Spadeyache/FATEN-RCJ26/k230-inference/data/captures/README.txt

/data/captures/ - BOOT-button camera captures are saved here.
