Spadeyache/FATEN-RCJ26/Docs/architecture.html

## How the Teensy, XIAO & K230D work as one system

A top-to-bottom map of the rescue robot's brain. The Teensy 4.1 is the conductor: it pulls in pre-chewed data from two smart co-processors (the XIAO ESP32-S3 camera and the K230D AI processor) plus its own onboard sensors, fuses and filters everything, decides which behaviour to run, and finally drives four wheels. Read top to bottom — each section zooms one level deeper.

Co-processor / sensor (input) Teensy processing Decision / state Actuator (output)

## 1 · The whole robot at a glance

Everything the Teensy reads is already simplified by the time it arrives. The XIAO does the heavy camera vision and hands over a few bytes; the K230D runs a YOLO model and hands over bounding boxes. The Teensy never touches raw pixels — it works with small, fast messages.

flowchart LR subgraph SRC["INPUTS — smart co-processors & sensors"] direction TB XIAO["📷 XIAO ESP32-S3
runs camera vision
(line, green, red, silver, gap)"] K230["🧠 K230D AI processor
YOLO model
(victim bounding boxes)"] IMU["🧭 IMU MPU6050
pitch / roll / yaw"] TOF["📏 ToF VL53L7CX
distance / walls"] TCH["👆 Touch + conductive
bump / wall contact"] end subgraph TEENSY["TEENSY 4.1 — the conductor"] direction TB RX["Raw byte transport
sensors/ layer"] PROC["Decode · filter · fuse
processing/ layer"] STATE["State machine
pick a behaviour"] ACT["Actions
PID, turn, forward, arm"] RX --> PROC --> STATE --> ACT end subgraph OUT["OUTPUTS"] direction TB MOT["⚙️ 4× STS wheels
FL FR BL BR"] ARM["🦾 KRS arm / gripper"] end XIAO -- "UART3 @ 4 Mbps
register protocol" --> RX K230 -- "UART8 @ 115k
frame protocol" --> RX IMU -- "I²C" --> RX TOF -- "I²C" --> RX TCH -- "GPIO" --> RX ACT -- "STS bus @ 1 Mbps" --> MOT ACT -- "KRS bus" --> ARM XIAO -. "mode cmd (LINE/EVAC/GAP)" .- PROC classDef src fill:#102a2c,stroke:#39c5cf,color:#e6edf3; classDef proc fill:#241a33,stroke:#bc8cff,color:#e6edf3; classDef dec fill:#2b2410,stroke:#d29922,color:#e6edf3; classDef out fill:#10271a,stroke:#3fb950,color:#e6edf3; class XIAO,K230,IMU,TOF,TCH src; class RX,PROC proc; class STATE dec; class ACT,MOT,ARM out;

Key idea: the Teensy is not doing image processing. The XIAO and K230D are offloaded brains that pre-digest the camera into tiny messages. This keeps the Teensy's control loop fast and deterministic.

## 2 · The 5-layer architecture

All firmware lives under src/<layer>/. The rule is strict: calls only flow downward. A layer never calls a layer above it. This is what keeps the "spaghetti" out — each box below only knows about the box beneath it.

flowchart TB SM["state_machine/
orchestrates behaviour
LINE_Follow · LINE_Gap · LINE_Obstacle · EVAC_*"] AC["actions/
blocking high-level motions
Drive (PID) · Turn · Forward · Arm"] PR["processing/
decode · filter · fuse
XiaoDecode · K230Decode · CommandFilter · Pose/EKF · Mapping"] SE["sensors/
raw I/O wrappers
XIAO_link · K230_link · IMU · ToF · Touch"] DR["drivers/
per-chip register wrappers
yacheSTS · yacheMPU6050 · yacheVL53L7CX · yacheEncodedSerial"] HW["🔌 hardware
UART · I²C · GPIO"] SM --> AC --> PR --> SE --> DR --> HW classDef dec fill:#2b2410,stroke:#d29922,color:#e6edf3; classDef out fill:#10271a,stroke:#3fb950,color:#e6edf3; classDef proc fill:#241a33,stroke:#bc8cff,color:#e6edf3; classDef src fill:#102a2c,stroke:#39c5cf,color:#e6edf3; classDef hw fill:#161b22,stroke:#30363d,color:#9da7b3; class SM dec; class AC out; class PR proc; class SE,DR src; class HW hw;

actions/
Blocking motions you call and wait on: Turn::turn(180,60), Forward::forward(60,35), Drive::runLinePID().

processing/
Turns raw bytes into meaning: a confirmed command code, a line error, a victim direction, a pose.

sensors/
Just moves bytes in/out. XIAO_link::get(reg) / send(reg,val). No interpretation.

drivers/
Per-chip register code (the "yache" wrappers). Speaks the actual chip language.

Adding new code? A new chip → drivers/. Reading raw bytes → sensors/. Decoding/fusing them → processing/. A motion primitive → actions/. A new behaviour → state_machine/.

## 3 · The main loop — one pass, every cycle

STS-imuMerge.ino → loop() is deliberately tiny. It runs the same 4-step pipeline forever: pump I/O → process → handle debug → run the active state.

flowchart LR A["1 · Pump sensor I/O
XIAO_link::tick()
K230_link::tick()
IMU / Touch tick()"] B["2 · Processing
XiaoDecode::tick()
K230Decode::tick()
(decode + filter + fuse)"] C["3 · Debug serial
'm' = map dump
'p' = pose print"] D["4 · Run active state
StateMachine::tick()
→ dispatches to current state"] A --> B --> C --> D D -. "loop forever" .-> A classDef proc fill:#241a33,stroke:#bc8cff,color:#e6edf3; classDef dec fill:#2b2410,stroke:#d29922,color:#e6edf3; class A,B,C proc; class D dec;

loop() {
Sensors::XIAO_link::tick(); // 1 — drain RX into register cache
Processing::XiaoDecode::tick(); // 2 — read cache, vote, expose lineError/command
while (Serial.available()) Mapping::handleSerial(...); // 3
StateMachine::tick(); // 4 — act
}

Why two steps per sensor? Step 1 (sensors/) only moves bytes — fast, non-blocking. Step 2 (processing/) interprets them. Splitting them means the transport never blocks on decode logic, and decode always works on the freshest cache.

## 4 · The XIAO ESP32-S3 path primary vision input

The XIAO runs the camera and boils each frame down to a handful of registers. Communication is a tiny register protocol over UART3 at 4 Mbps using YacheEncodedSerial — a 3-byte packet [255, reg, value].

### The register protocol

Register | ID | Direction | Meaning
XIAO_REG_FEATURE | 0x01 | Xiao → Teensy | Detected feature byte (green, red, silver, intersection, gap…) — the noisy raw vote
XIAO_REG_COM | 0x02 | Xiao → Teensy | Line centre-of-mass, 0..254 (127 = centred) — the steering error
XIAO_REG_ANGLE | 0x04 | Xiao → Teensy | Gap line angle, 0..254 (127 = 0°) — only meaningful in GAP mode
XIAO_REG_MODE | 0x03 | Teensy → Xiao | Tells the XIAO which vision program to run (see below)

### Teensy steers the XIAO's "mode"

The Teensy can re-task the camera by writing XIAO_REG_MODE. This is the one upward message — the state machine swaps the camera's job to match the behaviour it's running.

0 · LINE
Follow the black line, watch for green/red/silver/intersection glyphs.

1 · EVAC
Evacuation-zone vision.

2 · NOGI
No-green-intersection disambiguation (which arm of the cross to take).

3 · GAP
Line-gap mode — reports a gap angle to re-acquire the line.

### What the decode layer does with it

flowchart LR RAW["Register cache
XIAO_link::get(reg)"] COM["lineError()
= COM register
updated EVERY loop"] ANG["gapAngle()
= ANGLE register"] FEAT["FEATURE byte"] FILT["CommandFilter
majority vote @ 50 Hz
(15-frame ring buffer)"] CMD["command()
confirmed code 1–8"] RAW --> COM RAW --> ANG RAW --> FEAT --> FILT --> CMD classDef proc fill:#241a33,stroke:#bc8cff,color:#e6edf3; classDef src fill:#102a2c,stroke:#39c5cf,color:#e6edf3; class RAW src; class COM,ANG,FEAT,FILT,CMD proc;

Two speeds on purpose. lineError (steering) is time-critical, so it's read raw every loop. The FEATURE byte is noisy, so it's only trusted after surviving a vote — see next section.

## 5 · CommandFilter — turning noisy glyphs into trusted commands

A single camera frame can lie (motion blur, glare). So the raw FEATURE byte is never acted on directly. Instead, every value drops into a 15-slot ring buffer, and a command is only "confirmed" once it collects enough votes. Different events need different thresholds — a U-turn must be very sure; a line-loss can react faster.

flowchart TB IN["raw FEATURE byte
(each 50 Hz tick)"] Q["15-frame ring buffer
oldest vote falls off"] TALLY["Tally votes per category
left · right · u-turn · red · silver · black · no-line"] CHK{"reached
threshold?"} CONF["confirmed command 1–8"] ZERO["0 — nothing confirmed yet"] IN --> Q --> TALLY --> CHK CHK -- yes --> CONF CHK -- no --> ZERO classDef proc fill:#241a33,stroke:#bc8cff,color:#e6edf3; classDef dec fill:#2b2410,stroke:#d29922,color:#e6edf3; class IN,Q,TALLY proc; class CHK dec; class CONF,ZERO proc;

### Confirmed command codes & what they trigger

Code | Meaning | Threshold | LINE_Follow reaction
1 | U-turn glyph (green both sides) | ≥2 u-turn glyphs, or strong dual-green | 180° spin in place
2 | Green left | 4 votes | forward 35 mm + turn −75°, then green-cooldown
3 | Green right | 4 votes | forward 35 mm + turn +75°, then green-cooldown
4 | Red (stop) tile | 5 votes | → STALLED_RED (idle until red clears)
5 | Silver (evac entrance) | 4 votes | → EVAC_ENTRY
6 | No-green intersection | 6 black votes, ≤2 green | NGI sub-sequence (stop, NOGI mode, resample, go straight)
7 | NGI back-up variant | 2 black, 0 green | NGI sub-sequence (90° branch — future work)
8 | Sustained line loss | 3 votes | → LINE_GAP
0 | nothing confirmed | — | just run the line PID

Clever bit: the U-turn glyph (code 1) also counts as one vote toward both left and right, so a normal single-side green approach can never accidentally cross the U-turn threshold. Precedence: red → silver → u-turn → green → intersection → no-line.

## 6 · The K230D AI path victim detection

The K230D is a dedicated AI processor running a YOLO model. It streams bounding boxes over UART8 at 115 kbps. The Teensy sends it a 1-byte command every 100 ms — 0x00 idle or 0x01 detect — and parses the frames that come back.

### Wire format (binary frame)

[0xAA][0x55][COUNT] ( [CLS][SCORE][X1hi][X1lo][Y1hi][Y1lo][X2hi][X2lo][Y2hi][Y2lo] ) × COUNT [CHKSUM]

Each box = 10 bytes (class, score, and a hi/lo bounding rectangle). CHKSUM = XOR of every byte from the 0xAA header through the last box byte. Frame parsing lives in processing/K230Decode; the sensors/K230_link layer just buffers bytes and never understands framing.

flowchart LR K["K230D YOLO"] LINK["K230_link
buffer RX bytes
send 0x00/0x01 @ 10 Hz"] DEC["K230Decode
find header · check COUNT
verify XOR checksum"] BOX["decoded boxes
cls · score · x1y1x2y2"] VIC["checkVictim()
pick best silver/black"] GOAL["goalPOS
direction = (cx−320)/320
valid · cls · score"] K -- "UART8" --> LINK --> DEC --> BOX --> VIC --> GOAL GOAL -.-> EVAC["used by EVAC_Search
to drive toward a victim"] classDef src fill:#102a2c,stroke:#39c5cf,color:#e6edf3; classDef proc fill:#241a33,stroke:#bc8cff,color:#e6edf3; classDef dec fill:#2b2410,stroke:#d29922,color:#e6edf3; class K,LINK src; class DEC,BOX,VIC,GOAL proc; class EVAC dec;

Class mapping is flipped in the current model: raw 1 = silver, raw 0 = black. goalPOS.direction is the normalised left/right offset of the chosen victim in the 640-px frame — that's what the evac search state steers on.

## 7 · Onboard sensors — IMU · ToF · Touch

Beyond the two camera co-processors, the Teensy reads three local sensors directly. These feed slope compensation, evac-zone mapping, and obstacle handling.

🧭 IMU (MPU6050)

I²C. yacheMPU6050 driver → Sensors::IMU. Provides pitch / roll / yaw. Pitch can bias the wheel mix on slopes (WeightDistribution table); yaw feeds the EVAC pose/EKF.

📏 ToF (VL53L7CX)

I²C multi-zone distance array. yacheVL53L7CX driver. Used in the evacuation zone for wall ranging → Pose/EKF → Mapping (a 40×40 grid).

👆 Touch + conductive

GPIO. Front bumper has top priority in LINE_Follow — a bump immediately hands off to LINE_Obstacle before any camera command is considered.

## 8 · The state machine — choosing a behaviour

The robot is always in exactly one state. Each state is a namespace with onEnter() + update(). StateMachine::tick() dispatches to the active state every loop; a state requests a change with transitionTo(NEXT), which is applied at the start of the next tick (and fires the new state's onEnter()).

stateDiagram-v2 [*] --> LINE_FOLLOW LINE_FOLLOW --> LINE_OBSTACLE: touch front bumper LINE_FOLLOW --> LINE_GAP: cmd 8 (line lost) LINE_FOLLOW --> STALLED_RED: cmd 4 (red tile) LINE_FOLLOW --> EVAC_ENTRY: cmd 5 (silver) LINE_OBSTACLE --> LINE_FOLLOW: obstacle cleared LINE_GAP --> LINE_FOLLOW: line re-acquired STALLED_RED --> LINE_FOLLOW: red clears (cmd ≠ 4) EVAC_ENTRY --> EVAC_SEARCH EVAC_SEARCH --> EVAC_DEPLOY: victim reached EVAC_DEPLOY --> EVAC_EXIT: victim dropped EVAC_EXIT --> LINE_FOLLOW: back on the line note right of LINE_FOLLOW cmd 1/2/3 (U-turn, green L/R) are handled INLINE here — they act but stay in LINE_FOLLOW end note

LINE_*
The competition course: follow line, cross gaps, dodge obstacles, obey green/red glyphs.

EVAC_*
The evacuation zone: enter → search victims (K230D) → deploy in safe corner → exit → rejoin line.

STALLED_RED
No file — handled inline. Just stops until the XIAO stops reporting red.

## 9 · Inside LINE_Follow — priority dispatch

This is the default state and the clearest example of how a command turns into motion. Every tick it checks possibilities in strict priority order and acts on the first match; if nothing matches it just runs the PID.

flowchart TB T["LINE_Follow::update()"] G{"green cooldown
elapsed?"} TCH{"touch front?"} C{"confirmed
command?"} U["cmd 1 → 180° U-turn
(inline, stay in state)"] GR["cmd 2/3 → fwd + 90° green turn
start cooldown"] RED["cmd 4 → STALLED_RED"] EV["cmd 5 → EVAC_ENTRY"] NGI["cmd 6/7 → no-green-intersection seq
stop · NOGI mode · resample · go"] GAP["cmd 8 → LINE_GAP"] PID["default → Drive::runLinePID()"] T --> G --> TCH TCH -- yes --> OBS["→ LINE_OBSTACLE"] TCH -- no --> C C -- 1 --> U C -- "2/3" --> GR C -- 4 --> RED C -- 5 --> EV C -- "6/7" --> NGI C -- 8 --> GAP C -- "0 / none" --> PID classDef dec fill:#2b2410,stroke:#d29922,color:#e6edf3; classDef out fill:#10271a,stroke:#3fb950,color:#e6edf3; class T,G,TCH,C dec; class U,GR,RED,EV,NGI,GAP,PID,OBS out;

Heads-up — currently neutralised for bench tuning: in LINE_Follow.cpp the line reads const uint8_t cmd = 0; (the real XiaoDecode::command() call right above it is commented out). So right now the robot ignores all glyph commands and only does touch-handoff + pure PID. Re-enable the real command read to restore green/red/silver/gap behaviour.

## 10 · From line error to four wheels — the PID

When no command fires, Drive::runLinePID() converts the XIAO's line centre-of-mass into a left/right speed split. A background 9 ms IntervalTimer ISR then streams the four wheel gains to the STS servos — control math and the servo write are decoupled.

flowchart LR E["lineError 0..254
127 = centred"] M["rawError = (err−127)·200/127
→ ±200 scale"] P["PID
Kp 0.55 · Ki 0 · Kd 0.65"] MIX["asymmetric mix
L = base + corr·0.65
R = base − corr·1.3
(clamp −55..35)"] MOT["motor(L,R)
writes 4 gain globals"] ISR["⏱ 9 ms ISR
_sts.power(FL,FR,BL,BR)"] W["⚙️ STS wheels"] E --> M --> P --> MIX --> MOT -. "gains (volatile)" .-> ISR --> W classDef proc fill:#241a33,stroke:#bc8cff,color:#e6edf3; classDef out fill:#10271a,stroke:#3fb950,color:#e6edf3; class E,M,P,MIX proc; class MOT,ISR,W out;

Why asymmetric?
The L (×0.65) and R (×1.3) correction scales were hand-tuned: on a left-up/right-down sideways slope, making the lower side more aggressive (and allowing negative speed) tracked the line far better.

Why a 9 ms ISR?
The servo bus write happens on a timer, not in the main loop. motor() just updates four volatile gains; the ISR pushes them at a steady rate so wheel output never stutters when the loop is busy.

Slope / tilt comp
An optional path (imuCompensation + WeightDistribution table) scales the unloaded wheels by IMU pitch. Present but off by default in flat-line follow.

## 11 · Map vs. reality — what's actually running today

This diagram shows the full designed system. The current setup()/loop() only switches on a subset while you tune the new robot. Useful to know so the diagram doesn't mislead you on the bench.

Subsystem | Status in code today
XIAO link + decode | ● live — initialised and ticked every loop
Drive / PID / 4-wheel ISR | ● live
State machine | ● live (starts in LINE_FOLLOW)
LINE_Follow glyph commands | ◐ stubbed — cmd hardcoded to 0; only touch + PID active
K230D link + decode | ○ commented out in setup/loop
IMU | ○ commented out in setup/loop
Touch sensors | ○ commented out in setup/loop
Arm / KRS servos | ○ commented out in setup

To re-enable a subsystem: uncomment its ::init() in setup() and its ::tick() in loop(), and (for line glyphs) restore the real XiaoDecode::command() read in LINE_Follow::update().

Generated from the live source in teensy/STS-imuMerge/. Open this file in any browser — the diagrams render via Mermaid (needs internet for the one CDN script; everything else is offline).
