Spadeyache/FATEN-RCJ26/k230-final-train/report_victim.html

# K230D YOLOv8n パイプライン レポート 🇯🇵

生成: 2026-07-01 14:50 ・ nncase 2.11.0 ・ target k230

## 1. データセット / Dataset

クラス数 (nc)

3

クラス / classes

Dead, Live, Point

train 画像

984

val 画像

174

パス: /workspace/datasets/victim

## 2. 最良の量子化設定 / Best PTQ config v0_noclip_uint8_uint8

cosine (vs float ONNX)

0.9991

conf_delta

+0.000

サイズ size

3.40 MB

compile

42.4 s

## 3. PTQ スイープ結果 / Sweep (ranked by cosine)

variant | opt | calib | act/w | cosine↑ | conf_delta↑ | size MB↓ | compile s↓ | sim ms↓
v4_kld_uint8_int16 | 4 | Kld | uint8/int16 | 0.9999 | -0.209 | 6.41 | 133.6 | 55476
v5_kld_int16_uint8 | 5 | Kld | int16/uint8 | 0.9996 | -0.009 | 3.64 | 73.6 | 59118
v1_noclip_uint8_int16 | 1 | NoClip | uint8/int16 | 0.9995 | -0.022 | 6.40 | 42.0 | 73592
v3_kld_uint8_uint8 | 3 | Kld | uint8/uint8 | 0.9995 | -0.209 | 3.41 | 73.3 | 37526
v0_noclip_uint8_uint8 🏆 | 0 | NoClip | uint8/uint8 | 0.9991 | +0.000 | 3.40 | 42.4 | 37964

cosine が高いほど float ONNX と一致（量子化劣化が小さい）。conf_delta は検出信頼度の差（0 に近いほど良い）。sim ms は CPU シミュレータ速度であり実機 KPU 速度ではない（速度比較は size と compile を参照）。

## 4. searched vs preset 比較 / Comparison

metric | searched | preset | 勝ち / winner
cosine_mean | 0.9992 | 0.9992 | tie
conf_delta_mean | +0.009 | +0.009 | tie
sim_latency_ms | 24990 | 24788 | preset
kmodel_size_mb | 3.41 | 3.41 | tie
compile_seconds | 14.3 | 13.0 | preset

k230-final-train ・ 1 スクリプト (k230_pipeline.py) + 1 ノートブック ・ venv 不使用・Docker 実行
