Spadeyache/FATEN-RCJ26/k230-final-train/docs/diagnosis-reports/vis/i16_calib_image.jpg

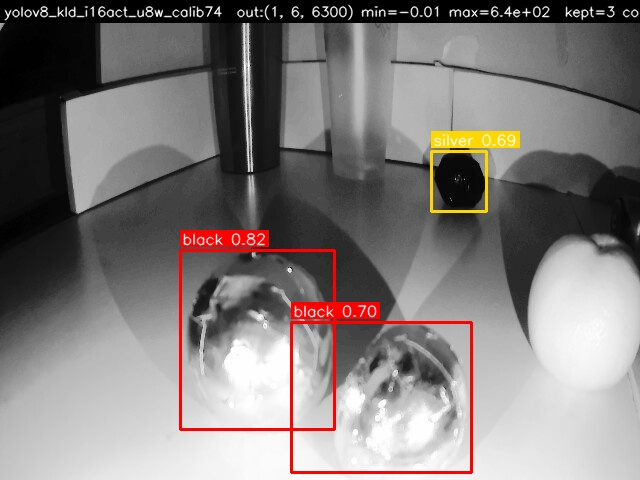
k230-final-train/docs/diagnosis-reports/vis/i16_calib_image.jpg
