Spadeyache/FATEN-RCJ26/k230-final-train/docs/diagnosis-reports/vis_unseen/yolov8_existing_float.jpg

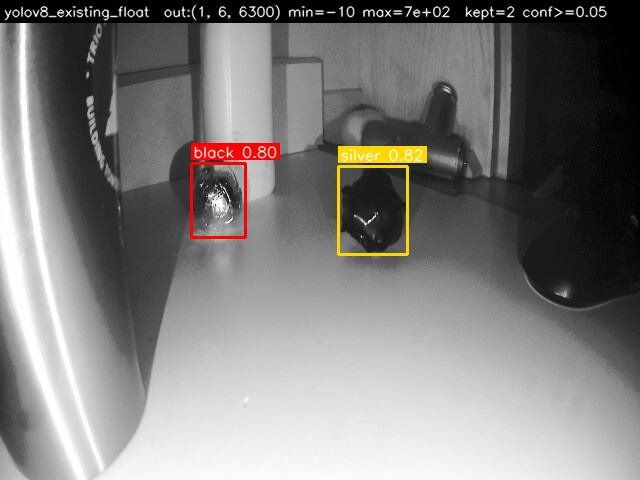
k230-final-train/docs/diagnosis-reports/vis_unseen/yolov8_existing_float.jpg
