Spadeyache/FATEN-RCJ26/electronics/3D_EXPORTS/3D_Teensy4.1_2026-05-24.step

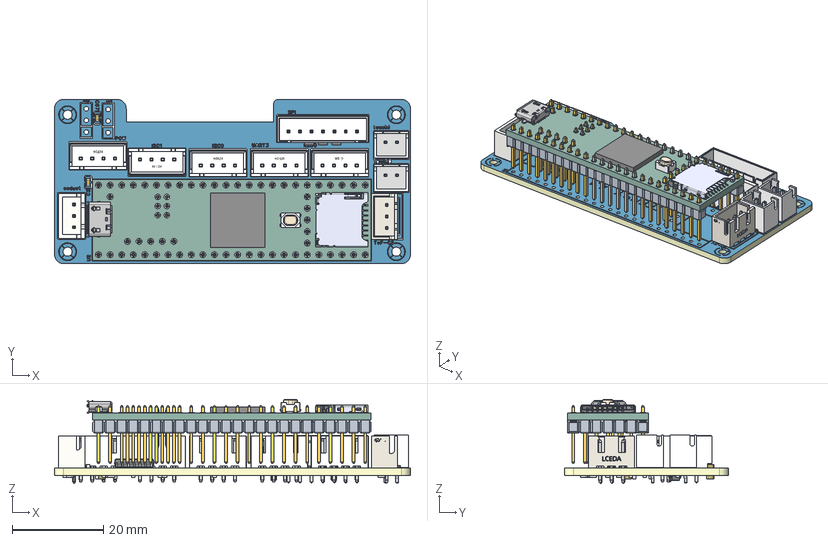
[picture p11: CAD file, 2026-05-24]
electronics/3D_EXPORTS/3D_Teensy4.1_2026-05-24.step
78.0 x 36.0 x 18.5 mm
Board~gWWy
TopCopper~gWWy
BottomCopper~gWWy
TopSilkscreen~gWWy
BottomSilkscreen~gWWy
TopFpcStiffener~gWWy
BottomFpcStiffener~gWWy
CONN-TH_3P-P2.50_BX-XH2.54-3PZZ~libraries\B3B-XH-A.step~gWWy x 4
TEENSY 4.1~Teensy 4.1 (With Headers).step~gWWy x 29
SOD-323_L1.7-W1.3-LS2.6-RD-1~SOD-323_L1.7-W1.3-LS2.6-RD-1~gWWy x 2
C0603~C0603_L1.6-W0.8-H0.8~gWWy x 6
R0603~R0603~gWWy x 12
CONN-TH_4P-P2.50_4PIN~CONN-TH_4P-P2.50_4PIN~gWWy x 5
CONN-TH_2P-P2.50_HX25003-2A~CONN-TH_2P-P2.50_HX25003-2A~gWWy x 2
CONN-TH_7P-P2.50_ZX-XH2.54-7PZZ~CONN-TH_7P_XHB-7A~gWWy
CONN-TH_3P-P2.50_BX-XH2.54-3PZZ~CONN-TH_3P-P2.50_A2501WV2-3P~gWWy
SOIC-14_L8.7-W3.9-P1.27-LS6.0-BL~SOIC-14_ L8.6-W3.9-H1.8-LS6.0-P1.27~gWWy
