Spadeyache/FATEN-RCJ26/electronics/Libralies/Seeeduino-XIAO-KICAD/seeeduino-xiao-samd21-3d-model/Seeeduino XIAO SAMD21 v4.step

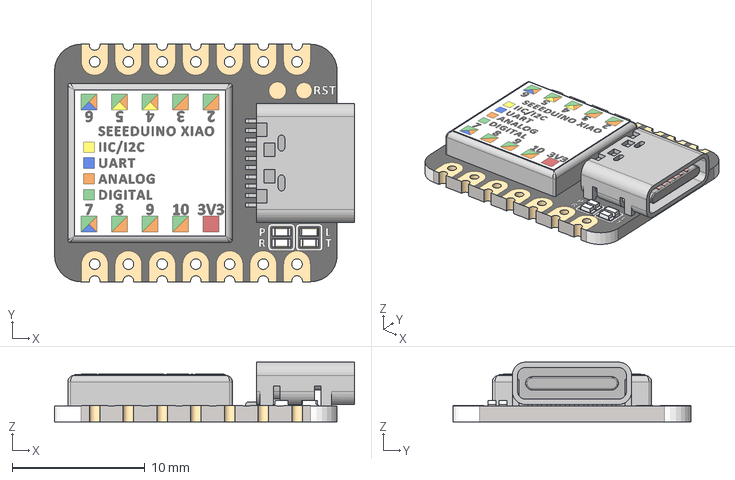
[picture p12: CAD file, 2026-07-18]
electronics/Libralies/Seeeduino-XIAO-KICAD/seeeduino-xiao-samd21-3d-model/Seeeduino XIAO SAMD21 v4.step
22.6 x 17.9 x 4.51 mm
