Spadeyache/FATEN-RCJ26/electronics/Libralies/Teensy4.1/DEV-16771.step

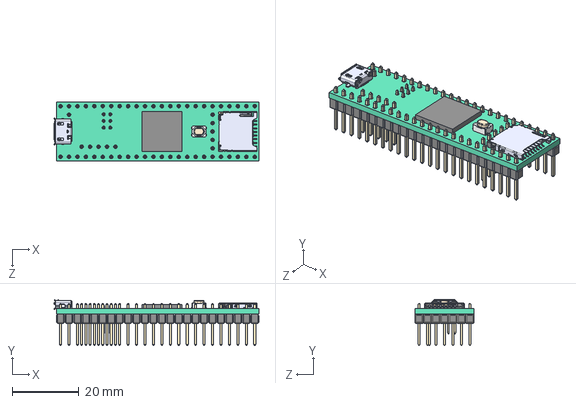
[picture p13: CAD file, 2026-07-18]
electronics/Libralies/Teensy4.1/DEV-16771.step
61.7 x 13.8 x 17.8 mm
