Spadeyache/FATEN-RCJ26/electronics/3D_EXPORTS/3D_PCB2_4_2026-05-24.step

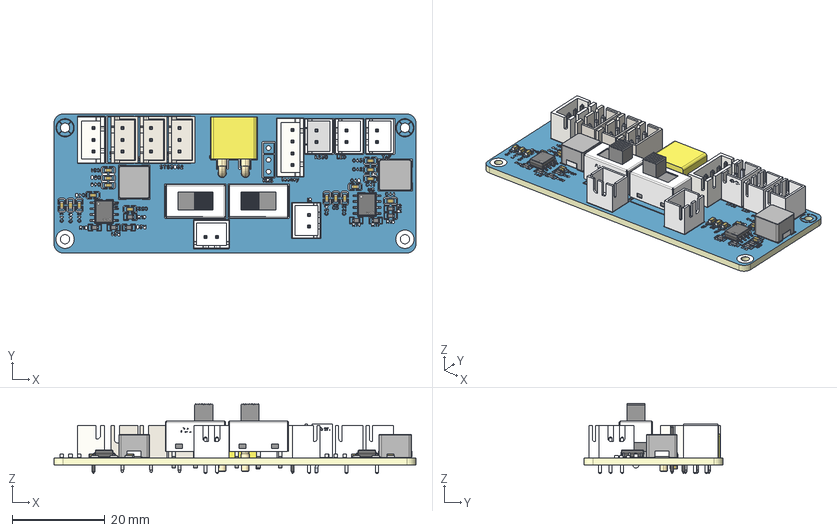
[picture p14: CAD file, 2026-05-24]
electronics/3D_EXPORTS/3D_PCB2_4_2026-05-24.step
78.0 x 30.0 x 15.1 mm
Board~qzRC
TopCopper~qzRC
BottomCopper~qzRC
TopSilkscreen~qzRC
BottomSilkscreen~qzRC
TopFpcStiffener~qzRC
BottomFpcStiffener~qzRC
CONN-TH_3P-P2.50_WAFER-XH2.54-3PZZ-H62~B3B-XH-A.step~qzRC x 4
CONN-TH_2P-P2.50_HX25003-2A~libraries\B2B-XH-A-TH.step~qzRC x 4
CONN-TH_B4B-XH-A-BK-LF-SN~libraries\B4B-XH-A.step~qzRC x 5
IND-SMD_CYA0650-3.3UH~IND-SMD_CYA0650-3.3UH~qzRC x 2
R0603~R0603~qzRC x 8
SW-TH_XKB_SS-12M11XX~SW-TH_XKB_SS-12M11XX~qzRC x 2
CONN-TH_XT30APW-M~CONN-TH_XT30APW-M~qzRC
C0603~C0603_L1.6-W0.8-H0.8~qzRC x 17
CONN-TH_2P-P2.50_HX25003-2A~CONN-TH_2P-P2.50_HX25003-2A~qzRC
CONN-TH_3P-P2.50_WAFER-XH2.54-3PZZ-H62~CONN-TH_3P-P2.50_ A2501WV2-3P~qzRC x 3
SO-8_L4.9-W3.9-P1.27-LS6.0-BL-EP~SO-8_L4.9-W3.9-H1.5-LS5.9-P1.27~qzRC x 2
