Spadeyache/FATEN-RCJ26/electronics/3D_EXPORTS/3D_PCB2_2026-05-24.step

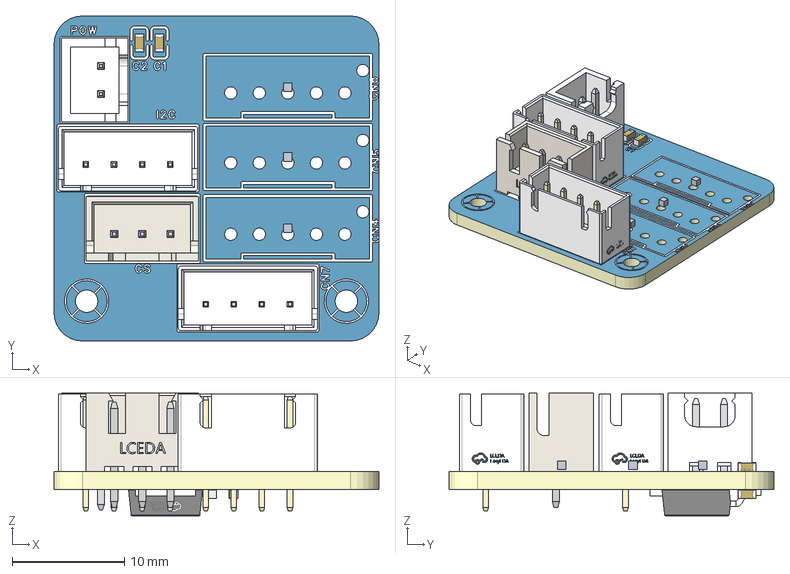
[picture p15: CAD file, 2026-05-24]
electronics/3D_EXPORTS/3D_PCB2_2026-05-24.step
28.9 x 28.9 x 10.9 mm
Board~xfXF
TopCopper~xfXF
BottomCopper~xfXF
TopSilkscreen~xfXF
BottomSilkscreen~xfXF
TopFpcStiffener~xfXF
BottomFpcStiffener~xfXF
CN6~CONN-TH_B5B-XH-AM-LF-SN~CONN-TH_B5B-XH-AM (LF)(SN)~xfXF x 3
CONN-TH_B2B-XH-A-2PZZ~CONN-TH_B2B-XH-A-2PZZ~xfXF
C0603~C0603_L1.6-W0.8-H0.8~xfXF x 4
CONN-TH_B4B-XH-A-G~CONN-TH_B4B-XH-A-G~xfXF x 2
CONN-TH_3P-P2.50_BX-XH2.54-3PZZ~CONN-TH_3P-P2.50_A2501WV2-3P~xfXF
TO-252-3_L6.6-W6.1-P4.57-LS9.9-BR-CW~TO-252-3_ L6.6-W6.1-P4.57-LS9.9-BR-CW~xfXF
