Spadeyache/FATEN-RCJ26/(list of files, cad)

Other CAD files:
electronics/Libralies/Seeeduino-XIAO-KICAD/seeeduino-xiao-samd21-3d-model/Seeeduino XIAO SAMD21 v4.f3d
