Spadeyache/FATEN-RCJ26/k230/train/data/calibration/0a55199c-2s1b_0042.jpg

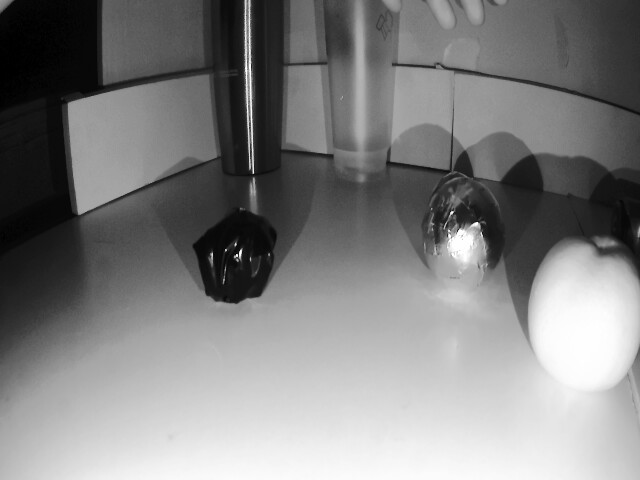
k230/train/data/calibration/0a55199c-2s1b_0042.jpg
