Spadeyache/FATEN-RCJ26/k230/train/data/calibration/01e56103-1s0b_0026.jpg

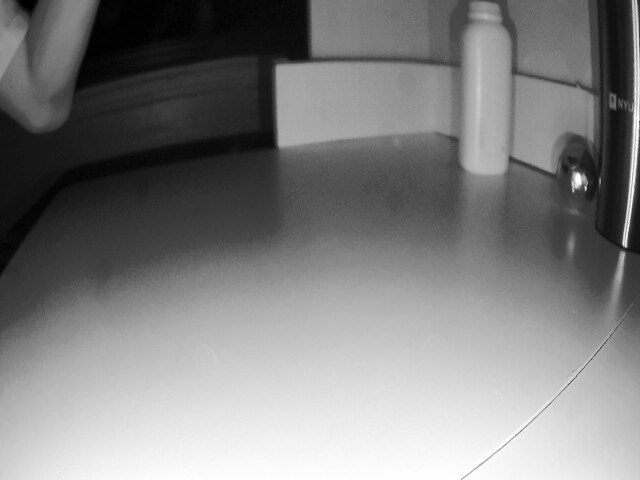
k230/train/data/calibration/01e56103-1s0b_0026.jpg
