Spadeyache/FATEN-RCJ26/k230/train/data/calibration/02e8b5ae-1s0b_0168.jpg

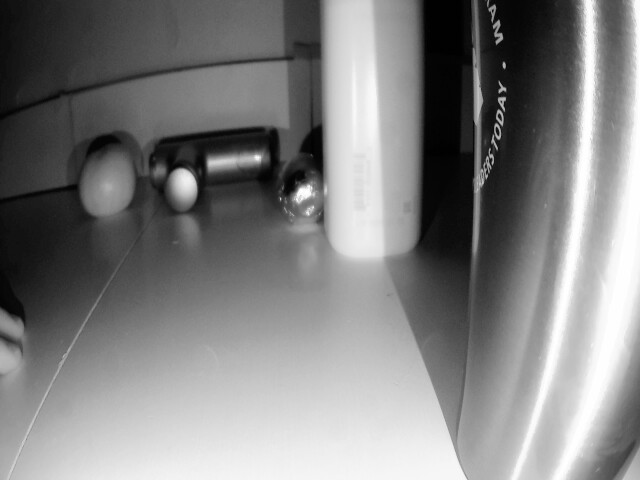
k230/train/data/calibration/02e8b5ae-1s0b_0168.jpg
