Spadeyache/FATEN-RCJ26/k230/train/data/calibration/003a746b-1s1b_0216.jpg

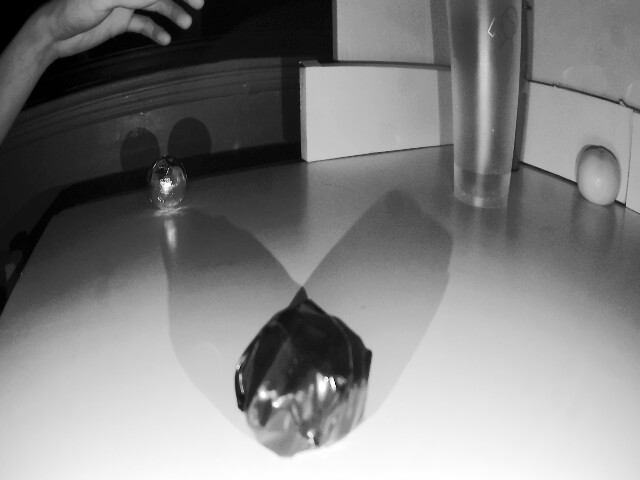
k230/train/data/calibration/003a746b-1s1b_0216.jpg
