Spadeyache/FATEN-RCJ26/k230/train/data/calibration/03cb1869-1s1b_0028.jpg

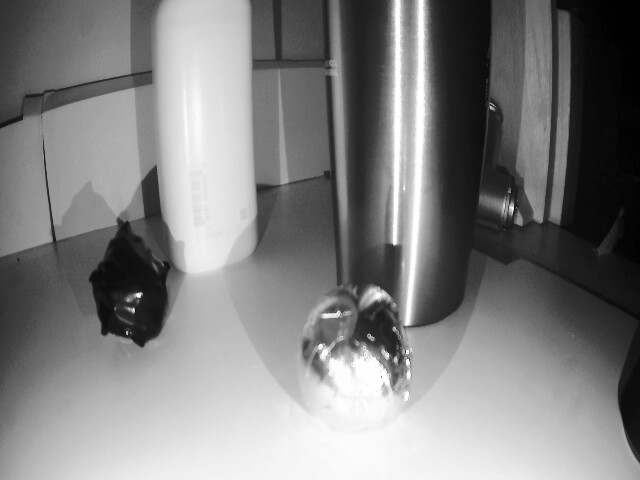
k230/train/data/calibration/03cb1869-1s1b_0028.jpg
