Spadeyache/FATEN-RCJ26/k230/train/data/calibration/03fe8503-1s0b_0232.jpg

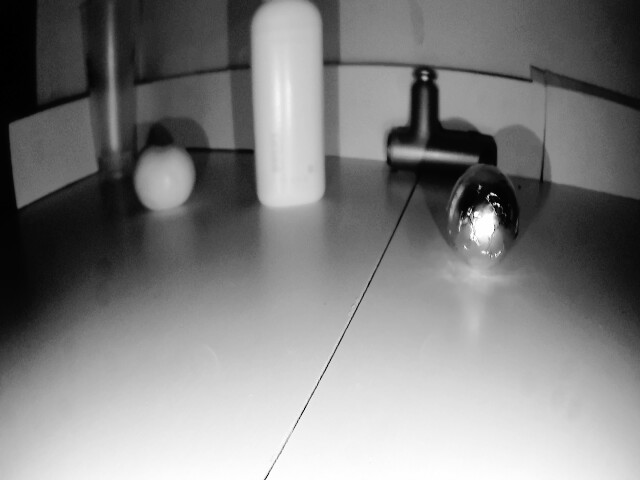
k230/train/data/calibration/03fe8503-1s0b_0232.jpg
