Spadeyache/FATEN-RCJ26/k230/train/data/calibration/04a01ca9-0s1b_0177.jpg

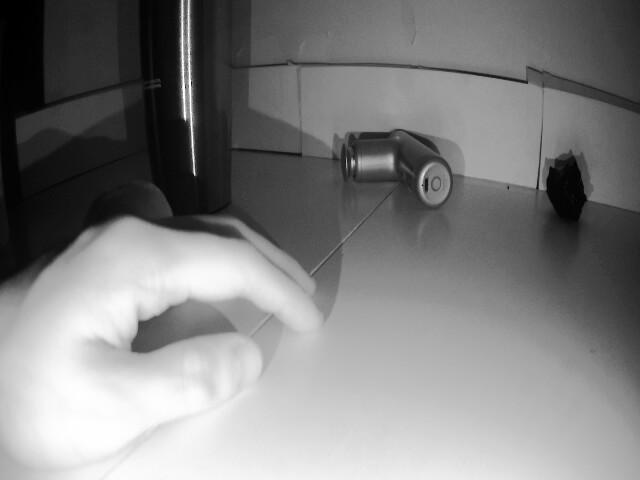
k230/train/data/calibration/04a01ca9-0s1b_0177.jpg
