Spadeyache/FATEN-RCJ26/k230/train/data/calibration/022f6ac8-1s0b_0222.jpg

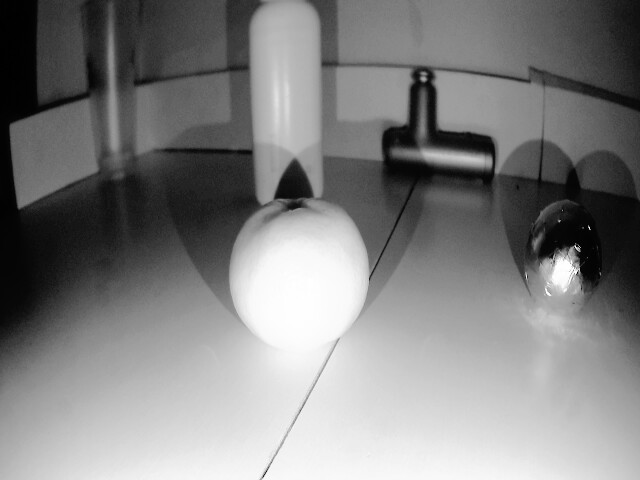
k230/train/data/calibration/022f6ac8-1s0b_0222.jpg
