Spadeyache/FATEN-RCJ26/k230/train/data/calibration/024b8494-0s1b_0068.jpg

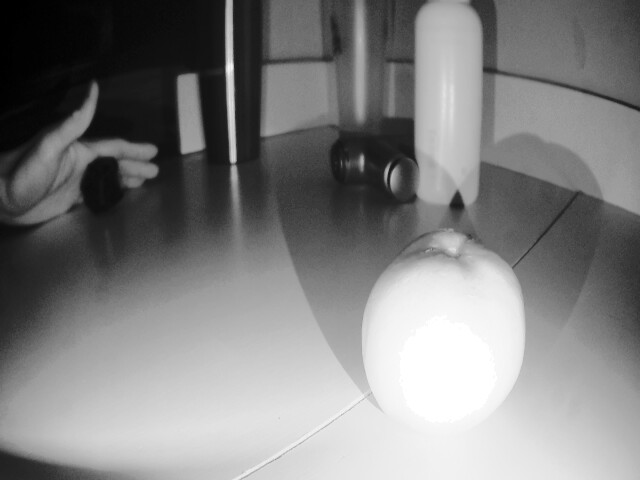
k230/train/data/calibration/024b8494-0s1b_0068.jpg
