Spadeyache/FATEN-RCJ26/k230/train/data/calibration/072ce14b-0s1b_0109.jpg

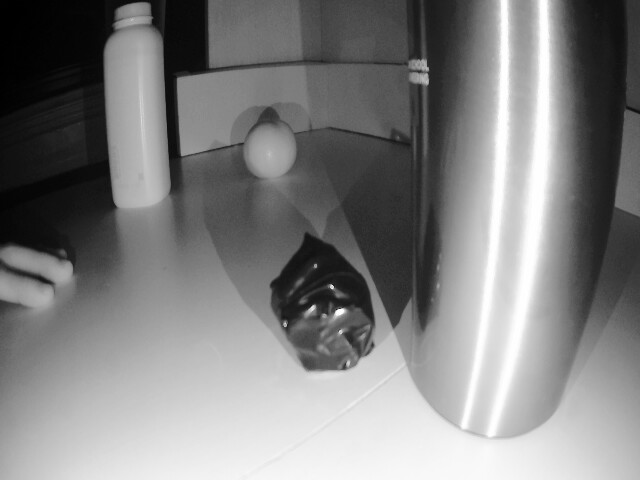
k230/train/data/calibration/072ce14b-0s1b_0109.jpg
