Spadeyache/FATEN-RCJ26/k230/train/data/calibration/078c85f7-0s1b_0168.jpg

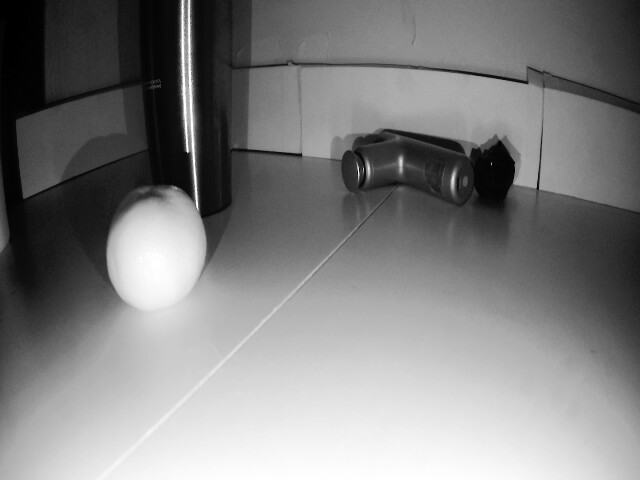
k230/train/data/calibration/078c85f7-0s1b_0168.jpg
