Spadeyache/FATEN-RCJ26/k230/train/data/calibration/0148e2fc-2s1b_0030.jpg

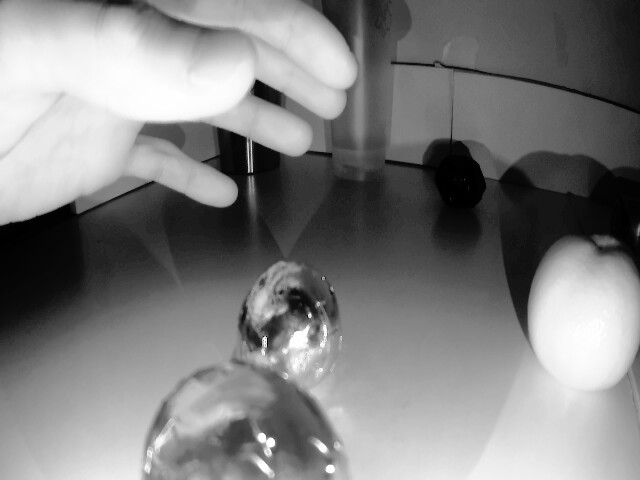
k230/train/data/calibration/0148e2fc-2s1b_0030.jpg
