Spadeyache/FATEN-RCJ26/k230/train/data/calibration/0849cd5c-2s1b_0013.jpg

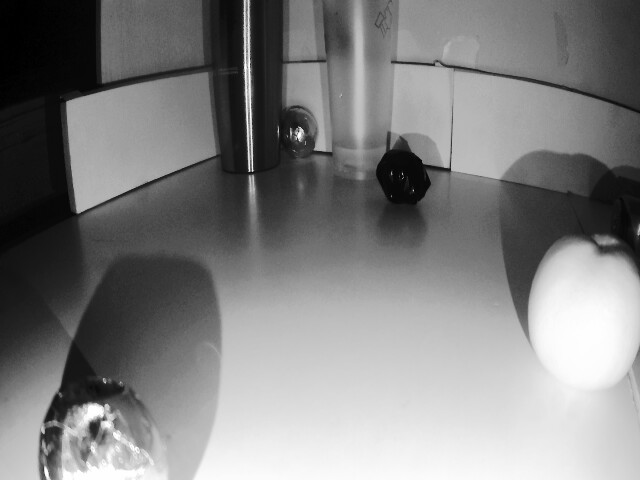
k230/train/data/calibration/0849cd5c-2s1b_0013.jpg
