Spadeyache/FATEN-RCJ26/k230/train/data/calibration/0968a3c5-2s1b_0046.jpg

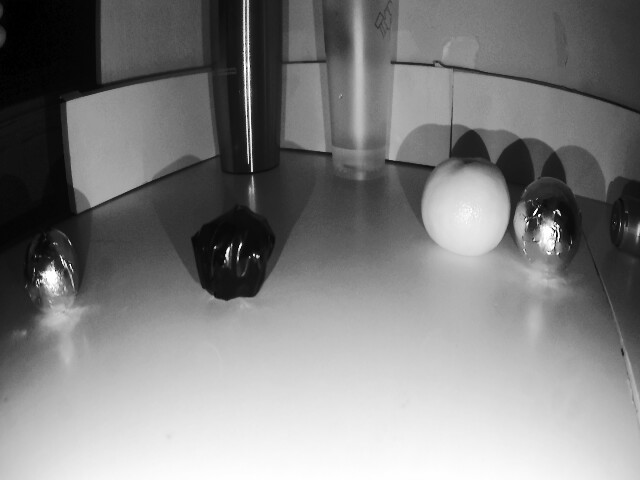
k230/train/data/calibration/0968a3c5-2s1b_0046.jpg
