Spadeyache/FATEN-RCJ26/k230/train/data/calibration/038856b1-1s1b_0162.jpg

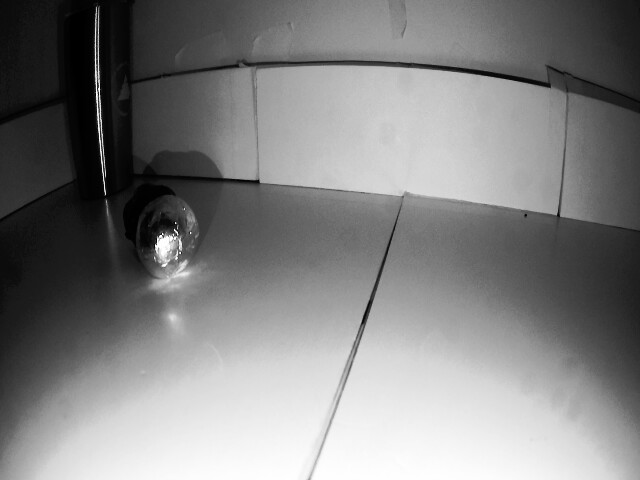
k230/train/data/calibration/038856b1-1s1b_0162.jpg
