Spadeyache/FATEN-RCJ26/k230/train/data/test_images/c27f5e94-2s1b_0031.jpg

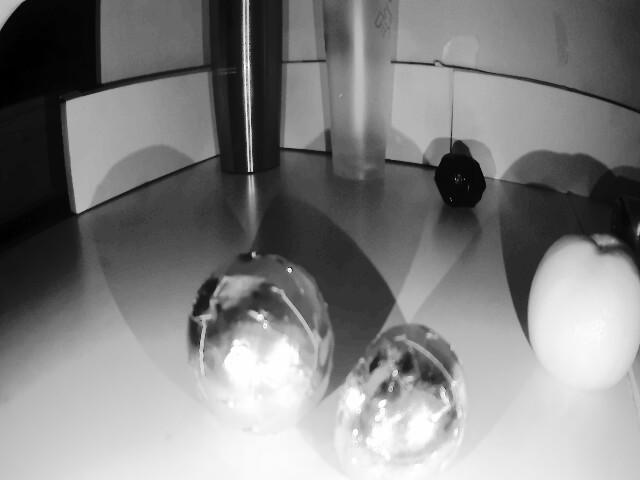
k230/train/data/test_images/c27f5e94-2s1b_0031.jpg
