Spadeyache/FATEN-RCJ26/k230/train/test.jpg

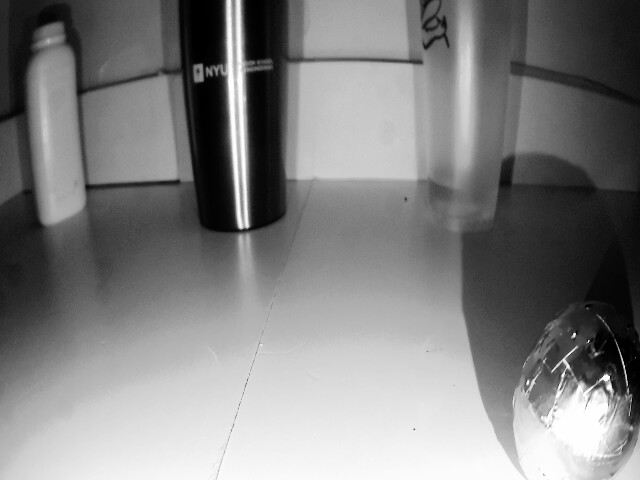
k230/train/test.jpg
