Spadeyache/FATEN-RCJ26/k230-final-train/docs/diagnosis-reports/vis_debug/yolov8_existing_float/04f0c278-1s1b_0187.jpg

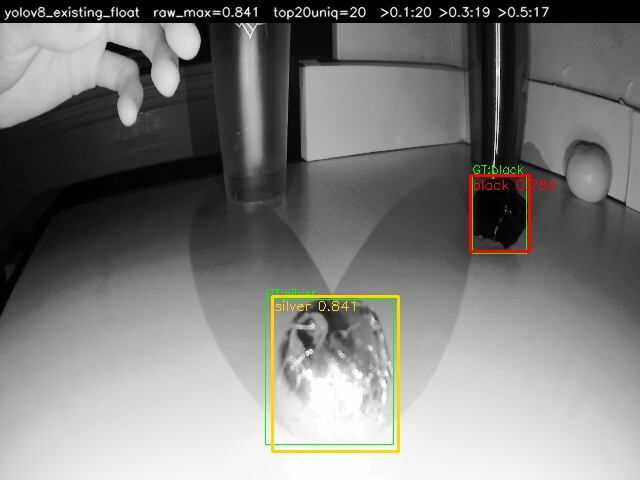
k230-final-train/docs/diagnosis-reports/vis_debug/yolov8_existing_float/04f0c278-1s1b_0187.jpg
