Spadeyache/FATEN-RCJ26/k230-final-train/docs/diagnosis-reports/vis_debug/yolov8_existing_float/031cf63e-2s1b_0123.jpg

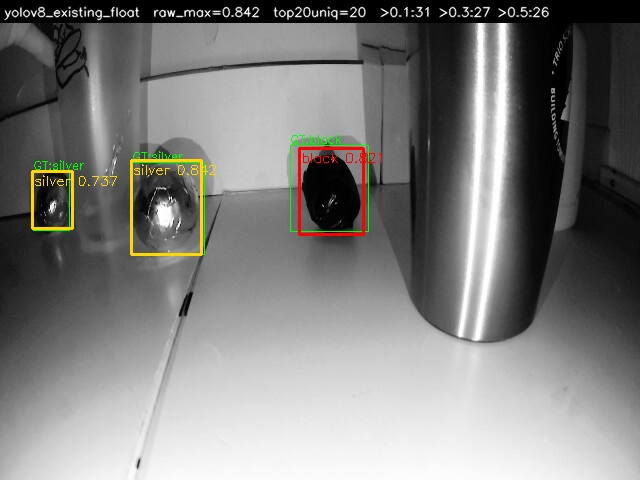
k230-final-train/docs/diagnosis-reports/vis_debug/yolov8_existing_float/031cf63e-2s1b_0123.jpg
