Spadeyache/FATEN-RCJ26/k230-final-train/docs/diagnosis-reports/vis_debug/yolov8_existing_float/049a61de-1s1b_0112.jpg

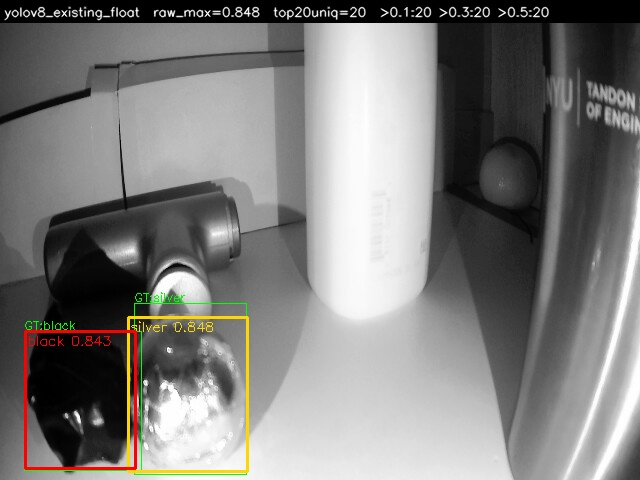
k230-final-train/docs/diagnosis-reports/vis_debug/yolov8_existing_float/049a61de-1s1b_0112.jpg
