Spadeyache/FATEN-RCJ26/k230-final-train/docs/diagnosis-reports/vis_debug/yolov8_existing_float/064d33e6-1s0b_0260.jpg

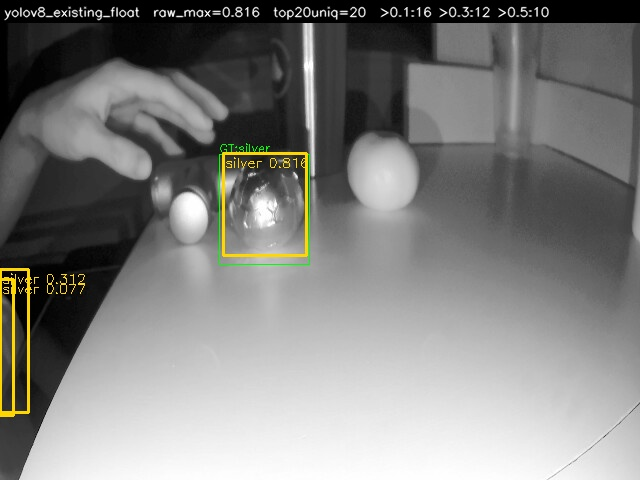
k230-final-train/docs/diagnosis-reports/vis_debug/yolov8_existing_float/064d33e6-1s0b_0260.jpg
