Spadeyache/FATEN-RCJ26/k230-final-train/docs/diagnosis-reports/vis_debug/yolov8_existing_float/0148e2fc-2s1b_0030.jpg

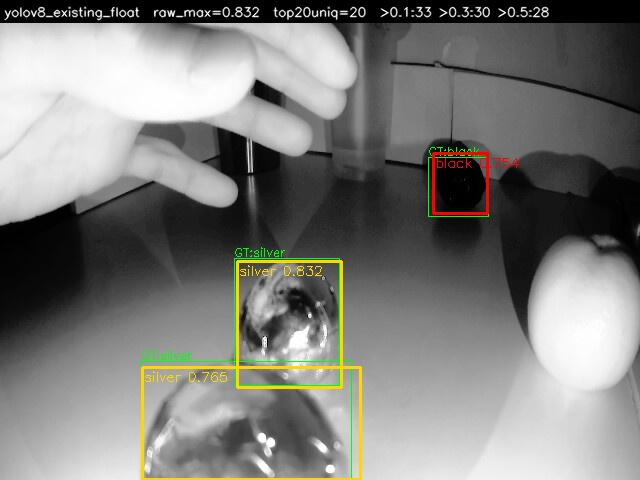
k230-final-train/docs/diagnosis-reports/vis_debug/yolov8_existing_float/0148e2fc-2s1b_0030.jpg
