Spadeyache/FATEN-RCJ26/k230-final-train/docs/diagnosis-reports/vis_debug/yolov8_existing_float/04885a34-1s0b_0009.jpg

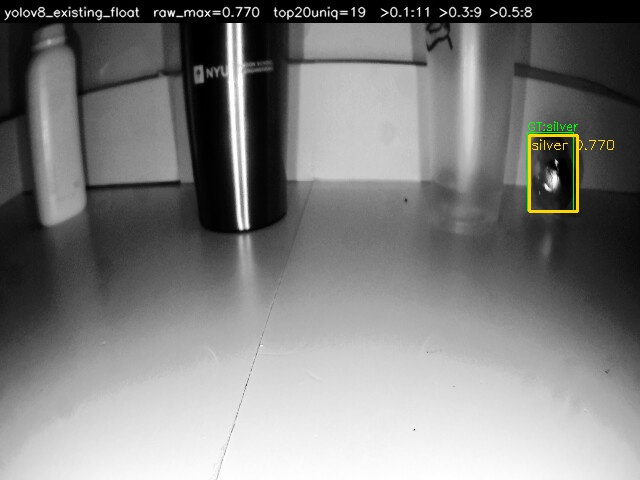
k230-final-train/docs/diagnosis-reports/vis_debug/yolov8_existing_float/04885a34-1s0b_0009.jpg
