Spadeyache/FATEN-RCJ26/k230-final-train/docs/diagnosis-reports/vis_debug/yolov8_existing_mix/003a746b-1s1b_0216.jpg

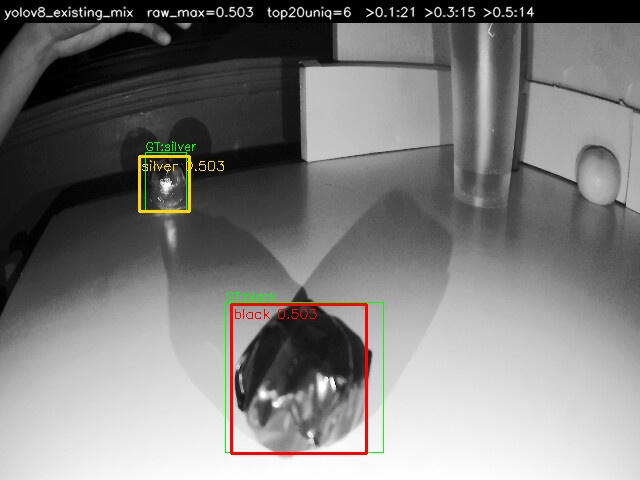
k230-final-train/docs/diagnosis-reports/vis_debug/yolov8_existing_mix/003a746b-1s1b_0216.jpg
