Spadeyache/FATEN-RCJ26/(list of files, drawings)

Other design files:
electronics/archive/easyEDA/1-12.eprj
electronics/archive/easyEDA/Final Main.eprj
electronics/archive/easyEDA/powermanagmen.eprj
electronics/archive/easyEDA/XIAO Board.eprj
electronics/archive/ProPrj_Final Main_2026-01-12.epro
electronics/laser_breakout_board.eprj
electronics/Main.eprj
electronics/XIAO ESP32C3 Adapter board copy.eprj
