Spadeyache/FATEN-RCJ26/teensy/STS-imuMerge/STS-imuMerge.ino

// =============================================================================
//  STS-imuMerge.ino — Arduino entry point

//  This file is intentionally tiny. All logic lives under src/<layer>/.
//  See README.md for the architecture overview and folder rules.
// =============================================================================



#include "config.h"
#include "pins_teensy.h"

#include "src/actions/Drive.h"
#include "src/actions/Forward.h"
#include "src/actions/Turn.h"

#include "src/actions/Arm.h"
#include "src/sensors/IMU.h"
#include "src/sensors/Touch.h"
#include "src/sensors/XIAO_link.h"
#include "src/sensors/K230_link.h"
#include "src/sensors/ToF.h"
#include "src/processing/XiaoDecode.h"
#include "src/processing/K230Decode.h"
// #include "src/processing/Mapping.h"   // DISABLED — see Mapping.*.disabled
#include "src/state_machine/StateMachine.h"

// Debug force-start. Set FORCE_START_STATE to 0 before normal runs.
#define FORCE_START_STATE 0
#define FORCE_STATE_TARGET StateMachine::EVAC_EXIT

FLASHMEM void setup() {
    Serial.begin(115200);

    // analogWrite(BUZZER_PIN, 30);
    pinMode(STS_EN_PIN, OUTPUT);
    digitalWrite(STS_EN_PIN, HIGH);
    pinMode(BUZZER_PIN, OUTPUT);
    tone(BUZZER_PIN, 9000, 300);

    Actions::Drive::init();
    Actions::Arm::init();           // servos + KRS, sets initial pose
    Sensors::IMU::init();
    Sensors::Touch::init();
    Sensors::XIAO_link::init();
    Sensors::K230_link::init();
    Sensors::ToF::init();  // Needed by EVAC_EXIT wall-follow.

    StateMachine::init();
#if FORCE_START_STATE
    StateMachine::transitionTo(FORCE_STATE_TARGET);
#endif

    // Avoid blocking startup here; the robot should enter loop() and start driving immediately.
    // Use a non-blocking status indicator if we need boot confirmation later.

    // delay(1000);
    delay(250);
    Actions::Arm::detachServos(); // sorry i wanted to save 16mAh and 225ms of time. i need to add this..
}

void loop() {
    
    // Actions::Drive::motorRaw(-40, 40,40,40);
    // Actions::Forward::forward(100, 80);
    // Actions::Turn::turn(90, 40);
    // Actions::Drive::motorRaw(60, -30,80,-50);
    // delay(1500);
    // return;
    // ========================================================================

    // 1. Pump sensor I/O (raw bytes in/out).
    Sensors::XIAO_link::tick();
    Sensors::K230_link::tick();
    Sensors::IMU::tick();
    Sensors::ToF::tick();       // updates global tofFL[8][8]
    // Sensors::ToF::printFL(); // optional debug dump
    Sensors::Touch::tick();

    // 2. Run processing layer (decode, filter, fuse).
    Processing::XiaoDecode::tick();
    Processing::K230Decode::tick();
    // Mapping::tick() is called by EVAC_* states only.

    // 3. Debug Serial commands ('m' = map dump, 'p' = pose print). DISABLED (mapping off).
    // while (Serial.available()) Processing::Mapping::handleSerial((char)Serial.read());


    // Actions::Arm::attachServos();
    // Actions::Arm::captureAlive();
    // Serial.println(Sensors::Touch::front());
    // delay(50);

    // Actions::Drive::motorRaw()
    // return;

    // 4. Run the active state.
    StateMachine::tick();
}
