Spadeyache/FATEN-RCJ26/xiaoesp/XIAOdev/log/cameraStream.ino

#include <WiFi.h>
#include "esp_camera.h"
#include "esp_http_server.h"

// --- WiFi Credentials ---
// const char *ssid = "nyu-media2.4GHz";
// const char *password = "Media@NYU";
const char *ssid = "Spadeyache32";
const char *password = "pkxc9kvozip2";

// --- XIAO ESP32-S3 Sense Camera Pins ---
#define PWDN_GPIO_NUM  -1
#define RESET_GPIO_NUM -1
#define XCLK_GPIO_NUM  10
#define SIOD_GPIO_NUM  40
#define SIOC_GPIO_NUM  39
#define Y9_GPIO_NUM    48
#define Y8_GPIO_NUM    11
#define Y7_GPIO_NUM    12
#define Y6_GPIO_NUM    14
#define Y5_GPIO_NUM    16
#define Y4_GPIO_NUM    18
#define Y3_GPIO_NUM    17
#define Y2_GPIO_NUM    15
#define VSYNC_GPIO_NUM 38
#define HREF_GPIO_NUM  47
#define PCLK_GPIO_NUM  13

httpd_handle_t stream_httpd = NULL;

static esp_err_t stream_handler(httpd_req_t *req) {
  camera_fb_t *fb = NULL;
  esp_err_t res = ESP_OK;
  char part_buf[128];

  res = httpd_resp_set_type(req, "multipart/x-mixed-replace;boundary=frame");
  if (res != ESP_OK) return res;

  httpd_resp_set_hdr(req, "Access-Control-Allow-Origin", "*");

  while (true) {
    fb = esp_camera_fb_get();
    if (!fb) {
      Serial.println("Camera capture failed");
      res = ESP_FAIL;
      break;
    }

    size_t hlen = snprintf(part_buf, sizeof(part_buf),
      "--frame\r\nContent-Type: image/jpeg\r\nContent-Length: %u\r\n\r\n",
      fb->len);

    res = httpd_resp_send_chunk(req, part_buf, hlen);
    if (res == ESP_OK)
      res = httpd_resp_send_chunk(req, (const char *)fb->buf, fb->len);
    if (res == ESP_OK)
      res = httpd_resp_send_chunk(req, "\r\n", 2);

    esp_camera_fb_return(fb);
    if (res != ESP_OK) break;
  }
  return res;
}

static esp_err_t snapshot_handler(httpd_req_t *req) {
  camera_fb_t *fb = esp_camera_fb_get();
  if (!fb) {
    httpd_resp_send_500(req);
    return ESP_FAIL;
  }
  httpd_resp_set_type(req, "image/jpeg");
  httpd_resp_set_hdr(req, "Access-Control-Allow-Origin", "*");
  httpd_resp_send(req, (const char *)fb->buf, fb->len);
  esp_camera_fb_return(fb);
  return ESP_OK;
}

void startCameraServer() {
  httpd_config_t config = HTTPD_DEFAULT_CONFIG();
  config.server_port = 80;
  config.max_uri_handlers = 4;

  httpd_uri_t stream_uri = {
    .uri     = "/stream",
    .method  = HTTP_GET,
    .handler = stream_handler,
    .user_ctx = NULL
  };

  httpd_uri_t snapshot_uri = {
    .uri     = "/snapshot",
    .method  = HTTP_GET,
    .handler = snapshot_handler,
    .user_ctx = NULL
  };

  if (httpd_start(&stream_httpd, &config) == ESP_OK) {
    httpd_register_uri_handler(stream_httpd, &stream_uri);
    httpd_register_uri_handler(stream_httpd, &snapshot_uri);
    Serial.println("Camera server started!");
  }
}

void initCamera() {
  camera_config_t config;
  config.ledc_channel = LEDC_CHANNEL_0;
  config.ledc_timer   = LEDC_TIMER_0;
  config.pin_d0       = Y2_GPIO_NUM;
  config.pin_d1       = Y3_GPIO_NUM;
  config.pin_d2       = Y4_GPIO_NUM;
  config.pin_d3       = Y5_GPIO_NUM;
  config.pin_d4       = Y6_GPIO_NUM;
  config.pin_d5       = Y7_GPIO_NUM;
  config.pin_d6       = Y8_GPIO_NUM;
  config.pin_d7       = Y9_GPIO_NUM;
  config.pin_xclk     = XCLK_GPIO_NUM;
  config.pin_pclk     = PCLK_GPIO_NUM;
  config.pin_vsync    = VSYNC_GPIO_NUM;
  config.pin_href     = HREF_GPIO_NUM;
  config.pin_sscb_sda = SIOD_GPIO_NUM;
  config.pin_sscb_scl = SIOC_GPIO_NUM;
  config.pin_pwdn     = PWDN_GPIO_NUM;
  config.pin_reset    = RESET_GPIO_NUM;
  config.xclk_freq_hz = 20000000;
  config.pixel_format = PIXFORMAT_JPEG;
  config.frame_size   = FRAMESIZE_VGA;  // 640x480
  config.jpeg_quality = 12;             // 0-63, lower = better quality
  config.fb_count     = 2;
  config.grab_mode    = CAMERA_GRAB_LATEST;

  esp_err_t err = esp_camera_init(&config);
  if (err != ESP_OK) {
    Serial.printf("Camera init FAILED: 0x%x\n", err);
    while (true) delay(1000);
  }

  sensor_t *s = esp_camera_sensor_get();
  s->set_brightness(s, 0);
  s->set_contrast(s, 0);
  s->set_saturation(s, 0);
  s->set_hmirror(s, 0);
  s->set_vflip(s, 0);

  Serial.println("Camera initialized OK");
}

void setup() {
  Serial.begin(115200);
  delay(2000);
  Serial.println("\n--- XIAO ESP32-S3 Camera Stream ---");

  initCamera();

  WiFi.mode(WIFI_STA);
  WiFi.begin(ssid, password);
  Serial.print("Connecting to WiFi");

  int attempts = 0;
  while (WiFi.status() != WL_CONNECTED && attempts < 20) {
    delay(500);
    Serial.print(".");
    attempts++;
  }

  if (WiFi.status() != WL_CONNECTED) {
    Serial.println("\nWiFi failed! Restarting...");
    ESP.restart();
  }

  Serial.println("\nWiFi Connected!");
  Serial.print("IP Address: ");
  Serial.println(WiFi.localIP());

  startCameraServer();

  Serial.println("\n--- Open these URLs in your browser ---");
  Serial.print("Live stream : http://");
  Serial.print(WiFi.localIP());
  Serial.println("/stream");
  Serial.print("Snapshot    : http://");
  Serial.print(WiFi.localIP());
  Serial.println("/snapshot");
}

void loop() {
  if (WiFi.status() != WL_CONNECTED) {
    Serial.println("WiFi lost, reconnecting...");
    WiFi.begin(ssid, password);
    delay(5000);
  }
  delay(10000);
}
