Spadeyache/FATEN-RCJ26/k230-inference/sdcard/zdev-files_ no need to have in k230/dev_camera.py

# dev_camera.py -- live camera preview using the production camera profile.

import gc
import sys
import time

for _p in ("/sdcard/app", "/sdcard/config", "/sdcard/customLib"):
    if _p not in sys.path:
        sys.path.insert(0, _p)

from media.sensor import *
from media.display import *
from media.media import *

import camera_profile as profile
import camera_setup


def main():
    print("=== dev_camera.py ===")
    sensor = Sensor()
    sensor.reset()
    camera_setup.apply_config(sensor)
    camera_setup.setup_button()

    if profile.SHOW_DISPLAY:
        Display.init(Display.VIRT, sensor.width(), sensor.height(), to_ide=True)
    MediaManager.init()
    sensor.run()
    time.sleep_ms(profile.SETTLE_MS)

    frame = 0
    try:
        while True:
            img = camera_setup.get_image(sensor)
            saved = camera_setup.maybe_save(img)
            if saved:
                print("saved ->", saved)
            if profile.SHOW_DISPLAY:
                Display.show_image(img)
            frame += 1
            if (frame & 0x1F) == 0:
                gc.collect()
    except KeyboardInterrupt:
        print("\nstopping...")
    finally:
        sensor.stop()
        if profile.SHOW_DISPLAY:
            Display.deinit()
        MediaManager.deinit()
        print("done.")


if __name__ == "__main__":
    main()
