Spadeyache/FATEN-RCJ26/k230-inference/codelog/Yolov8nrun2.py

from libs.PipeLine import PipeLine
from libs.YOLO import YOLOv8
from libs.Utils import *
import os,sys,gc
import ulab.numpy as np
import image


if __name__=="__main__":

    # 这里仅为示例，自定义场景请修改为您自己的模型路径、标签名称、模型输入大小
    kmodel_path= "/data/kmodel/best_640x480_k230_float.kmodel"
#    kmodel_path="/data/kmodels/best_320_k230d.kmodel"

#    kmodel_path="/sdcard/examples/kmodel/face_alignment_post.kmodel"
    labels = ["black","silver"]
    model_input_size = [640, 480]

    # 添加显示模式，默认hdmi，可选hdmi/lcd/lt9611/st7701/hx8399/nt35516,其中hdmi默认置为lt9611，分辨率1920*1080；lcd默认置为st7701，分辨率800*480
    display_mode="lcd"
    rgb888p_size=[640,480]
    confidence_threshold = 0.01
    nms_threshold=0.015
    # 初始化PipeLine
    pl=PipeLine(rgb888p_size=rgb888p_size,display_mode=display_mode)
    pl.create()
    display_size=pl.get_display_size()
    # 初始化YOLOv8实例
    yolo=YOLOv8(task_type="detect",mode="video",kmodel_path=kmodel_path,labels=labels,rgb888p_size=rgb888p_size,model_input_size=model_input_size,display_size=display_size,conf_thresh=confidence_threshold,nms_thresh=nms_threshold,max_boxes_num=50,debug_mode=0)
    yolo.config_preprocess()
    while True:
        with ScopedTiming("total",1):
            # 逐帧推理
            img=pl.get_frame()
            res=yolo.run(img)
            yolo.draw_result(res,pl.osd_img)
            pl.show_image()
            gc.collect()
    yolo.deinit()
    pl.destroy()
