Spadeyache/FATEN-RCJ26/(commit log)

2026-05-12 Add quant-aware weight finetuning to kmodel converter
    - convert_to_kmodel3.py: expose --finetune-weights flag (defaults to UseSquant)
    so PTQ runs nncase's quant-aware weight refinement. Recovers most of the
    confidence lost to int8/uint8 quantization without retraining.
    - summarize_workspace.py: small helper that prints a per-file summary of the
    workspace (docstrings + pipeline order).
    - yolo_training_explained.html: standalone reference doc covering the YOLO
    training pipeline and K230D-specific accuracy tips.
2026-05-17 Add yolov5 training workspace files
    [Add_output_0.csv, Concat_1_output_0.csv, Concat_2_output_0.csv, Concat_output_0.csv, Conv_output_0.csv, GlobalAveragePool_output_0.csv, HardSigmoid_output_0.csv, Mean.csv]
2026-05-19 kmodel quantized sumilation
    [TileAct1_0.csv, TileAct1_1.csv, TileLayerGroup_0.csv, TileLayerGroup_1.csv, TileLayerGroup_10.csv, TileLayerGroup_11.csv, TileLayerGroup_12.csv, TileLayerGroup_13.csv]
2026-05-21 pcb schematic completed
    [Main.eprj, laser_breakout_board.eprj]
2026-05-22 PCB update
    [Main.eprj, laser_breakout_board.eprj]
2026-05-22 breackout design done!
    [laser_breakout_board.eprj]
2026-05-23 teensy and pow update for international
    [Main.eprj]
2026-05-24 PCB ordere batch
    [3D_PCB2_2026-05-24.step, 3D_PCB2_4_2026-05-24.step, 3D_Teensy4.1_2026-05-24.step, Add_output_0.csv, Concat_1_output_0.csv, Concat_2_output_0.csv, Concat_output_0.csv, Conv_output_0.csv]
2026-05-25 Restructure teensy/STS-imuMerge into layered src/ tree
2026-05-29 teensy restructure code
    [Add_output_0.csv, Concat_1_output_0.csv, Concat_2_output_0.csv, Concat_output_0.csv, Conv_output_0.csv, GlobalAveragePool_output_0.csv, HardSigmoid_output_0.csv, Mean.csv]
2026-06-08 teensy update
2026-06-12 pin cofiguration
2026-06-13 clean up code pid and vibration removed
    [Drive.cpp, Drive.h, LINE_Follow.cpp, config.h]
2026-06-19 line follow with green intersection updated teensy state control logic
2026-06-20 Saving my current work here
2026-06-21 delay to init tof is fixed
    [STS-imuMerge.ino, ToF.cpp]
2026-06-21 gap, red, green with cmd filter implemneted
2026-06-22 before adding linefollow edge case.
2026-06-23 ai model train restrucutre
    [eval_bgr.csv, eval_config_based.csv, eval_float.csv, eval_gray3.csv, eval_qat_onnx_float.csv, eval_rgb.csv, eval_their_yolov8_kld_u8u8_on_train.csv, eval_their_yolov8_kld_u8u8_on_val.csv]
2026-06-24 not working but checkpoint line folow
    [Arm.cpp, Arm.h, Drive.cpp, EVAC_Entry.cpp, K230Decode.cpp, K230Decode.h, LINE_Follow.cpp, ModeGap.cpp]
2026-06-25 intersection added with cmd filter in xiao
2026-06-26 krs PWM can HS45HB connected
2026-06-26 arm macros
2026-06-27 arm grabs
2026-06-28 calibration values tuned
2026-07-01 calibrated to com@
2026-07-01 comm before imu timer
2026-07-01 push code before imu chagne
2026-07-01 imu delay fixed
2026-07-11 untrack datasets/model dump fix .gitignore and add license with some readme updates
    [Add_output_0.csv, Concat_1_output_0.csv, Concat_2_output_0.csv, Concat_output_0.csv, Conv_output_0.csv, GlobalAveragePool_output_0.csv, HardSigmoid_output_0.csv, Mean.csv]
2026-07-17 removed unused files
    [1-12.eprj, Batter Management v3.kicad_sch, Battery Management.kicad_pcb, Battery Management.kicad_sch, Electronics.kicad_pcb, Electronics.kicad_sch, Faten.kicad_sch, Final Main.eprj]
2026-07-18 removed notused html files
    [1-12.eprj, 3D_PCB2_2026-05-24.step, 3D_PCB2_4_2026-05-24.step, 3D_Teensy4.1_2026-05-24.step, Batter Management v3.kicad_sch, Battery Management.kicad_pcb, Battery Management.kicad_sch, DEV-16771.step]
